imihajlow/discrete-clock/models/clock.asc

C1: cap; 1000µ
D1: diode; 1N4148
D2: diode; 1N4148
D3: diode; 1N4148
D4: diode; 1N4148
M1: nmos; 2N7002
M2: nmos; 2N7002
R1: res; 10
R2: res; 20k
R3: res; 20k
V1: voltage; 5
V2: voltage; SINE(0 6 50)
Named nets: 0, COM
.tran 0 1
