imihajlow/discrete-clock/models/reset.asc

C1: cap; 0.63µ
D1: diode; 1N4148
M1: nmos; 2N7002
M2: nmos; 2N7002
R1: res; 20k
R2: res; 100k
R3: res; 100k
R4: res; 20k
V1: voltage; PULSE(0 5 0 1m 1m 1 2)
Named nets: 0, COM
.tran 0 10
