imihajlow/discrete-clock/models/counter.asc

C1: cap; 1n
D1: diode; 1N4148
D2: diode; 1N4148
D3: diode; 1N4148
D4: diode; 1N4148
D5: diode; 1N4148
D6: diode; 1N4148
D7: diode; 1N4148
D8: diode; 1N4148
D9: diode; 1N4148
D10: diode; 1N4148
D11: diode; 1N4148
D12: diode; 1N4148
D13: diode; 1N4148
D14: diode; 1N4148
D15: LED; NSCW100
D16: LED; NSCW100
D17: LED; NSCW100
D18: LED; NSCW100
M1: nmos; 2N7002
M2: nmos; 2N7002
M3: nmos; 2N7002
R1: res; 20k
R2: res; 20k
R3: res; 10k
R4: res; 10k
R5: res; 10k
R6: res; 10k
R7: res; 40k
R8: res; 50
R9: res; 50
R10: res; 50
R11: res; 50
V1: voltage; 5
V2: voltage; PULSE(0 5 0 100n 100n 500m 1)
V3: voltage; PULSE(0 5 500m 100n 100n 500m 1)
V4: voltage; PULSE(0 5 2.6 1n 1n 29 60)
V5: voltage; PULSE(0 5 1700m 100n 100n 670m 1.7)
X1: ff-arst-nmos-diode
X2: ff-arst-nmos-diode
X3: ff-arst-nmos-diode
X4: ff-arst-nmos-diode
X5: ff-arst-nmos-diode
X6: ff-arst-nmos-diode
X7: ff-arst-nmos-diode
X8: ff-arst-nmos-diode
X9: nxor
Named nets: 0, RST, Q1, NQ1, Vcc, NQ2, NQ4, NQ8, Q2, Q4, Q8, RSTin, NC, C, Bin
.tran 0 40
