imihajlow/discrete-clock/models/nxor.asc

D1: diode; 1N4148
D2: diode; 1N4148
D3: diode; 1N4148
D4: diode; 1N4148
D5: diode; 1N4148
D6: diode; 1N4148
M1: nmos; 2N7002
M2: nmos; 2N7002
M3: nmos; 2N7002
M4: nmos; 2N7002
R1: res; 20k
R2: res; 20k
R3: res; 20k
R4: res; 20k
Named nets: A, NA, B, Q, NQ, 0, Vcc, NB
