imihajlow/discrete-clock/models/ff-arst-nmos-diode.asc

C1: cap; {C}
C2: cap; {C}
C3: cap; {C}
C4: cap; {C}
C5: cap; {C}
C6: cap; {C}
C7: cap; {C}
C8: cap; {C}
D1: diode; 1N4148
D2: diode; 1N4148
D3: diode; 1N4148
D4: diode; 1N4148
D5: diode; 1N4148
D6: diode; 1N4148
D7: diode; 1N4148
D8: diode; 1N4148
D9: diode; 1N4148
D10: diode; 1N4148
D11: diode; 1N4148
D12: diode; 1N4148
D13: diode; 1N4148
D14: diode; 1N4148
D15: diode; 1N4148
D16: diode; 1N4148
D17: diode; 1N4148
D18: diode; 1N4148
D19: diode; 1N4148
D20: diode; 1N4148
M1: nmos; 2N7002
M2: nmos; 2N7002
M3: nmos; 2N7002
M4: nmos; 2N7002
M5: nmos; 2N7002
M6: nmos; 2N7002
M7: nmos; 2N7002
M8: nmos; 2N7002
R1: res; {R}
R3: res; {R}
R5: res; {R}
R7: res; {R}
R9: res; {R}
R11: res; {R}
R13: res; {R}
R15: res; {R}
Named nets: 0, NCLK, ARST, CLK, Q, NQ, Vcc, G1, G2, G3, G4, G5, G6, G7, G8, NS1, NR1, NS2, NR2, Q0, NQ0
.param R=20k
.param C=0.01p
