imihajlow/discrete-clock/models/ff-async-reset-nmos-res.asc

M1: nmos; 2N7002
M2: nmos; 2N7002
M3: nmos; 2N7002
M4: nmos; 2N7002
M5: nmos; 2N7002
M6: nmos; 2N7002
M7: nmos; 2N7002
M8: nmos; 2N7002
M9: nmos; 2N7002
M10: nmos; 2N7002
M11: nmos; 2N7002
M12: nmos; 2N7002
M13: nmos; 2N7002
M14: nmos; 2N7002
M15: nmos; 2N7002
M16: nmos; 2N7002
M17: nmos; 2N7002
M18: nmos; 2N7002
M19: nmos; 2N7002
M20: nmos; 2N7002
M21: nmos; 2N7002
R1: res; 5k
R2: res; 5k
R3: res; 5k
R4: res; 5k
R5: res; 5k
R6: res; 5k
R7: res; 5k
R8: res; 5k
R9: res; 1k
V1: voltage; 5
V2: voltage; PULSE(0 5 0 10u 10u 1 2)
V3: voltage; PULSE(0 5 400m 1m 1m 5.6666 6.73285)
Named nets: Vcc, 0, CLK, !CLK, RI, Q, QI, RES, SI
.tran 10u 60
