imihajlow/discrete-clock/sch/display-module/display-module.kicad_pcb

## KiCad design sch/display-module/display-module.kicad_pcb (2019-01-13)

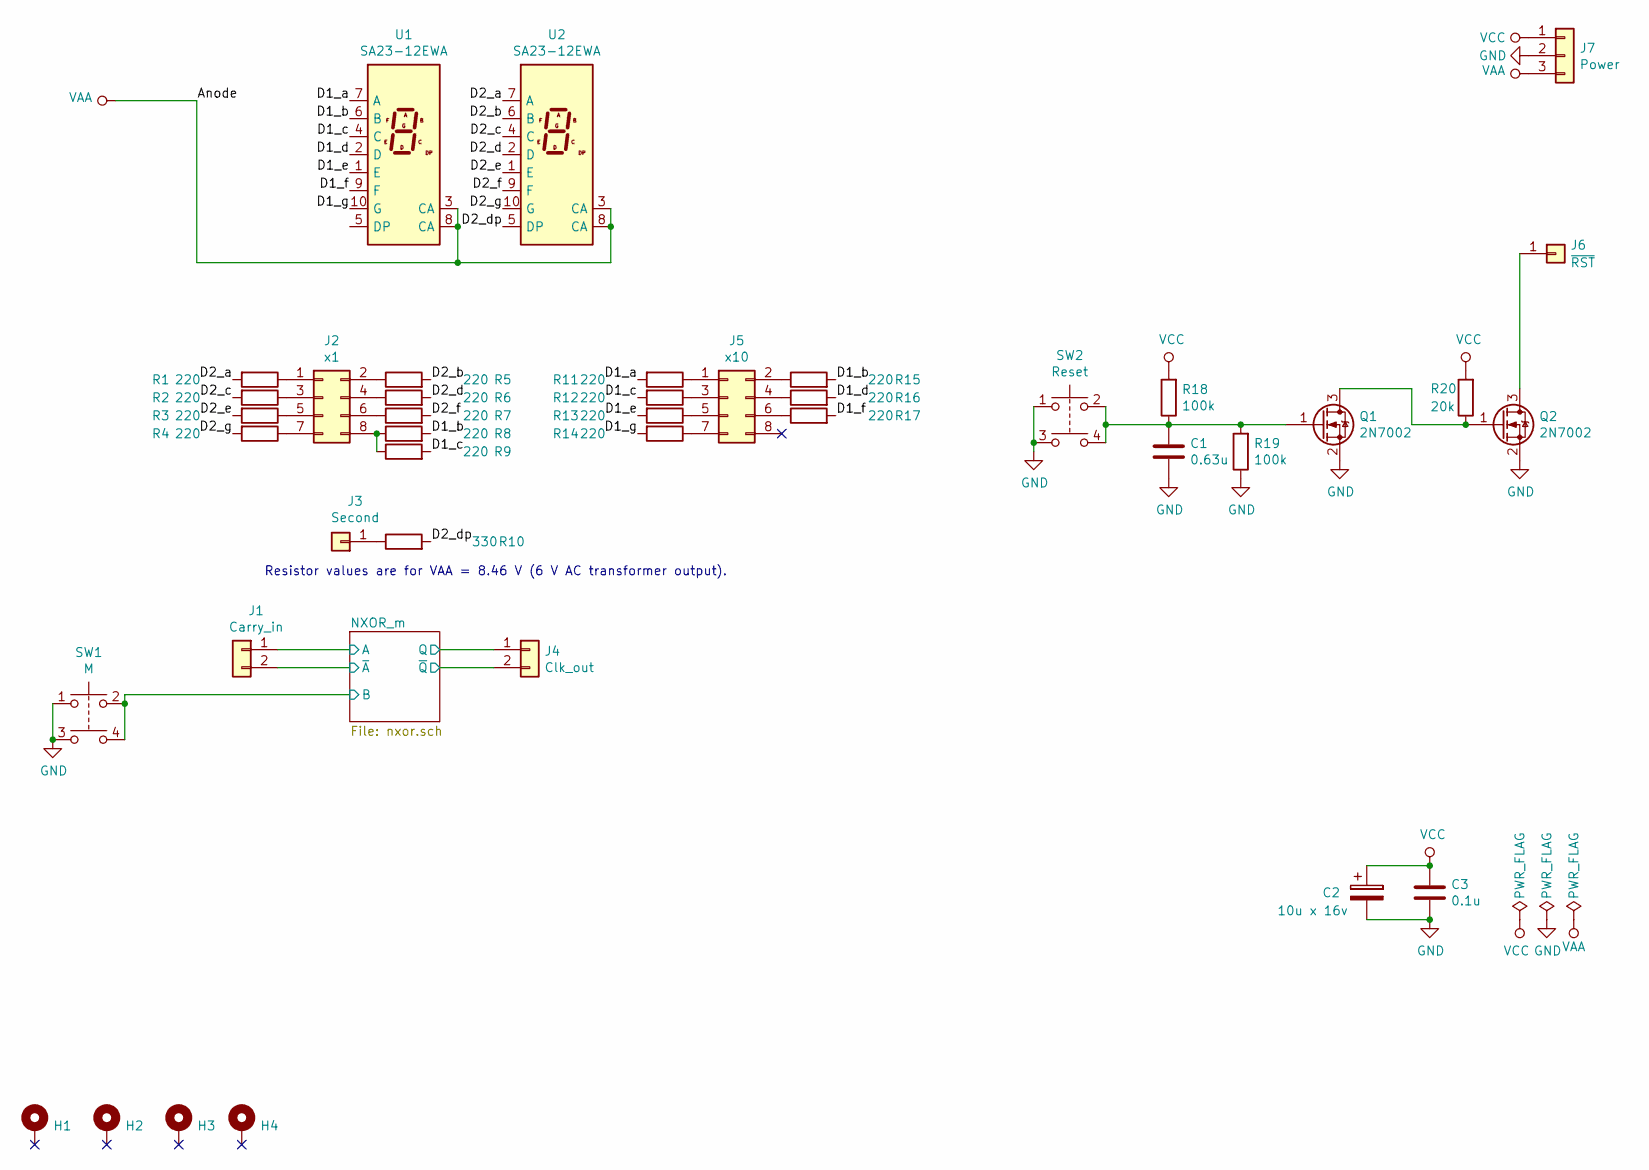
[picture p1: schematic display-module.sch]

Parts:
C1: 0.63u; C_0805_2012Metric
C2: 10u x 16v; CP_EIA-3528-21_Kemet-B_Pad1.50x2.35mm_HandSolder
C3: 0.1u; C_0805_2012Metric
H1, H2, H3, H4: MountingHole_Pad; MountingHole_3.2mm_M3_DIN965_Pad
J1: Carry_in; PinHeader_1x02_P2.54mm_Vertical
J2: x1; IDC-Header_2x04_P2.54mm_Vertical
J3: Second; PinHeader_1x01_P2.54mm_Vertical
J4: Clk_out; PinHeader_1x02_P2.54mm_Vertical
J5: x10; IDC-Header_2x04_P2.54mm_Vertical
J6: ~RST; PinHeader_1x01_P2.54mm_Vertical
J7: Power; PinHeader_1x03_P2.54mm_Vertical
Q1, Q2: 2N7002; SOT-23
R1, R2, R3, R4, R5, R6, R7, R8, R9, R11, R12, R13, R14, R15, R16, R17: 220; R_0805_2012Metric
R10: 330; R_0805_2012Metric
R18, R19: 100k; R_0805_2012Metric
R20: 20k; R_0805_2012Metric
SW1: M; DTS-644
SW2: Reset; DTS-644
U1, U2: SA23-12EWA; SA10-21HWA

Connections:
/D1_a: R11.2, U1.7 (A)
/D1_b: R8.2, R15.2, U1.6 (B)
/D1_c: R9.2, R12.2, U1.4 (C)
/D1_d: R16.2, U1.2 (D)
/D1_e: R13.2, U1.1 (E)
/D1_f: R17.2, U1.9 (F)
/D1_g: R14.2, U1.10 (G)
/D2_a: R1.2, U2.7 (A)
/D2_b: R5.2, U2.6 (B)
/D2_c: R2.2, U2.4 (C)
/D2_d: R6.2, U2.2 (D)
/D2_dp: R10.2, U2.5 (DP)
/D2_e: R3.2, U2.1 (E)
/D2_f: R7.2, U2.9 (F)
/D2_g: R4.2, U2.10 (G)
/NXOR_m/A: J1.1; also elsewhere on the board
/NXOR_m/B: SW1.2, SW1.4; also elsewhere on the board
/NXOR_m/Q: J4.1; also elsewhere on the board
/NXOR_m/~A: J1.2; also elsewhere on the board
/NXOR_m/~Q: J4.2; also elsewhere on the board
GND: C1.2, C2.2, C3.2, J7.2, Q1.2 (S), Q2.2 (S), R19.1, SW1.1, SW1.3, SW2.1, SW2.3; also elsewhere on the board
unnamed: C1.1, Q1.1 (G), R18.1, R19.2, SW2.2, SW2.4
unnamed: J2.1, R1.1
unnamed: J2.2, R5.1
unnamed: J2.3, R2.1
unnamed: J2.4, R6.1
unnamed: J2.5, R3.1
unnamed: J2.6, R7.1
unnamed: J2.7, R4.1
unnamed: J2.8, R8.1, R9.1
unnamed: J3.1, R10.1
unnamed: J5.1, R11.1
unnamed: J5.2, R15.1
unnamed: J5.3, R12.1
unnamed: J5.4, R16.1
unnamed: J5.5, R13.1
unnamed: J5.6, R17.1
unnamed: J5.7, R14.1
unnamed: J6.1, Q2.3 (D)
unnamed: Q1.3 (D), Q2.1 (G), R20.1
VAA: J7.3, U1.3 (CA), U1.8 (CA), U2.3 (CA), U2.8 (CA)
VCC: C2.1, C3.1, J7.1, R18.2, R20.2; also elsewhere on the board

Notes on the sheet:
Resistor values are for VAA = 8.46 V (6 V AC transformer output).

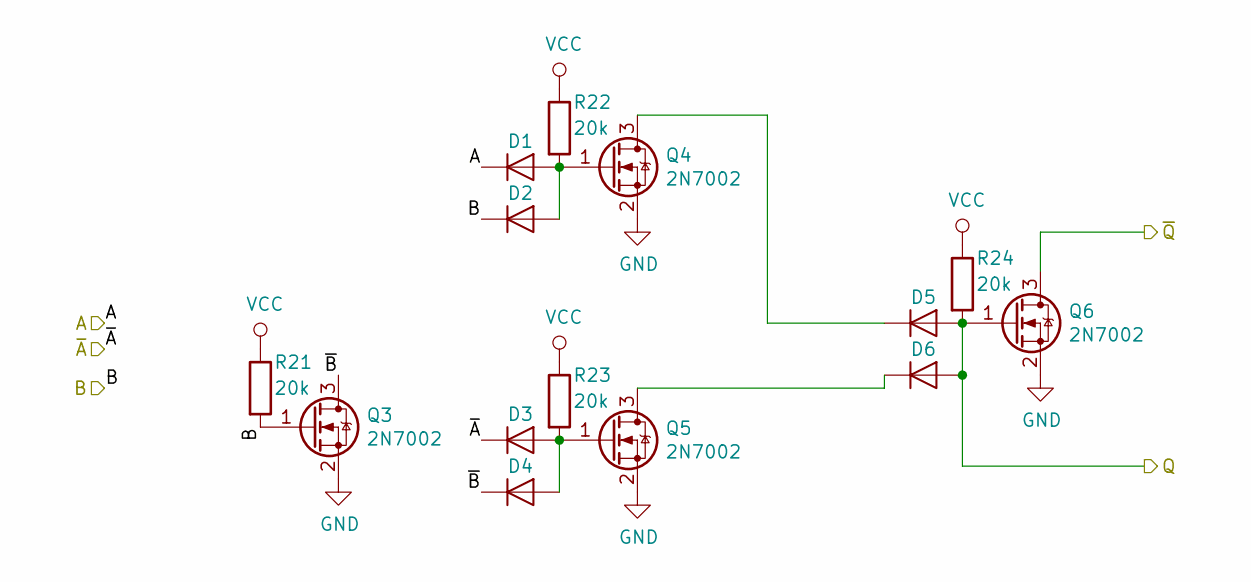
[picture p2: schematic nxor.sch]

Parts:
D1, D2, D3, D4, D5, D6: LL103C; D_MiniMELF
Q3, Q4, Q5, Q6: 2N7002; SOT-23
R21, R22, R23, R24: 20k; R_0805_2012Metric

Connections:
/NXOR_m/A: D1.1 (K); also elsewhere on the board
/NXOR_m/B: D2.1 (K), Q3.1 (G), R21.2; also elsewhere on the board
/NXOR_m/Q: D5.2 (A), D6.2 (A), Q6.1 (G), R24.2; also elsewhere on the board
/NXOR_m/~A: D3.1 (K); also elsewhere on the board
/NXOR_m/~B: D4.1 (K), Q3.3 (D)
/NXOR_m/~Q: Q6.3 (D); also elsewhere on the board
GND: Q3.2 (S), Q4.2 (S), Q5.2 (S), Q6.2 (S); also elsewhere on the board
unnamed: D1.2 (A), D2.2 (A), Q4.1 (G), R22.2
unnamed: D3.2 (A), D4.2 (A), Q5.1 (G), R23.2
unnamed: D5.1 (K), Q4.3 (D)
unnamed: D6.1 (K), Q5.3 (D)
VCC: R21.1, R22.1, R23.1, R24.1; also elsewhere on the board

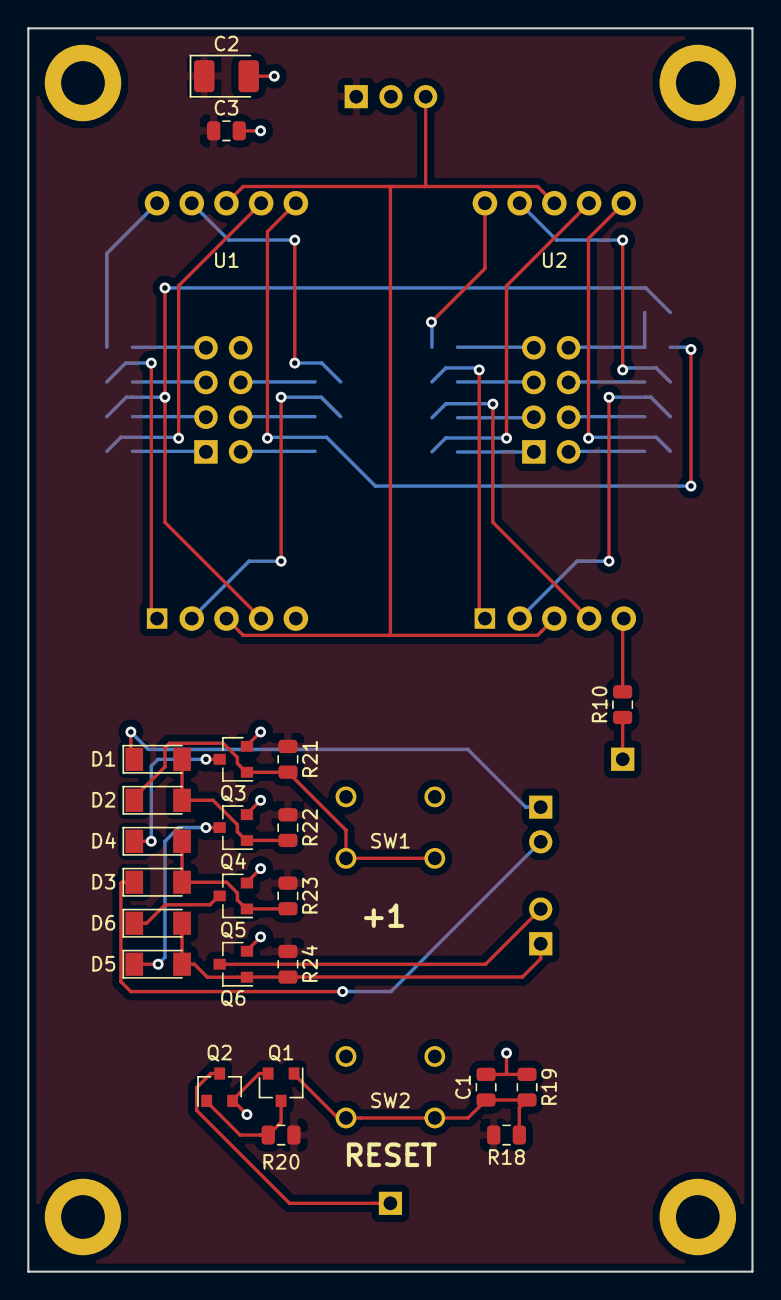
[picture p3: board display-module.kicad_pcb from above]

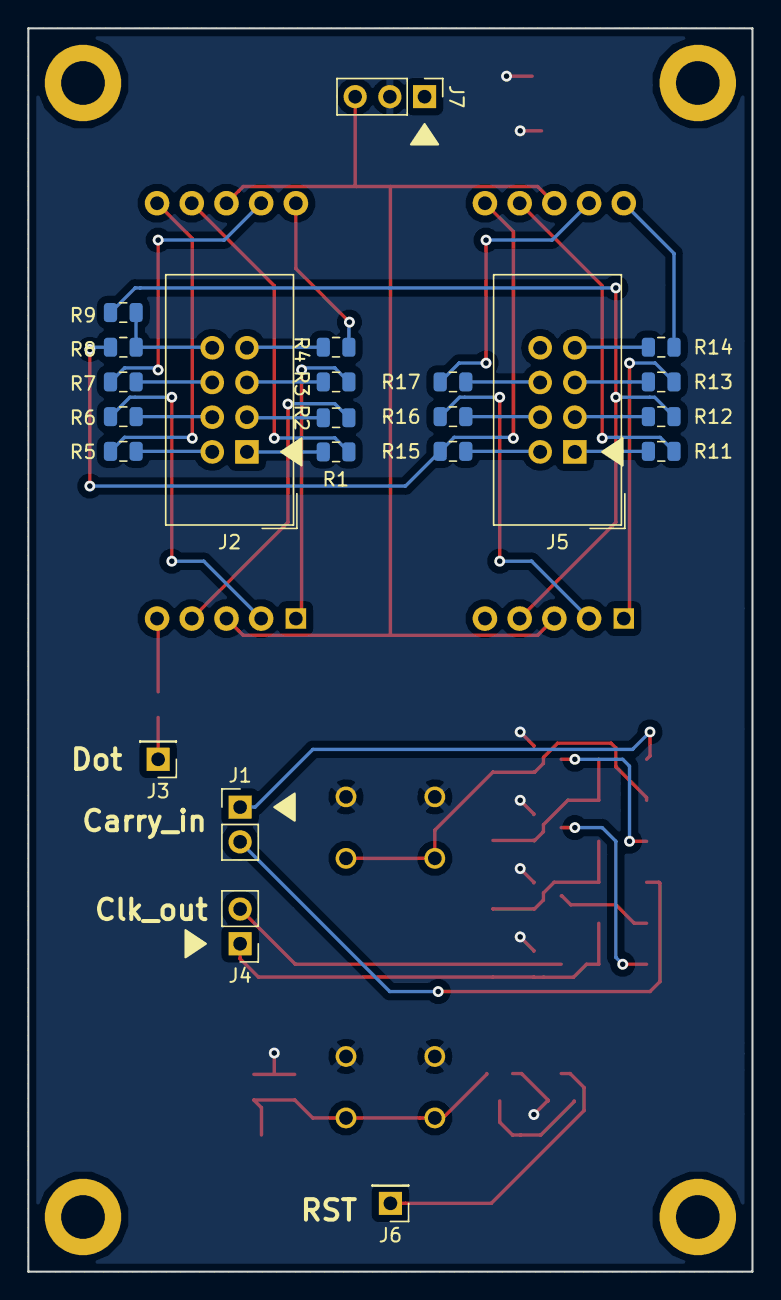
[picture p4: board display-module.kicad_pcb from below]

Board: 2 copper layers, 53.0 x 91.0 mm, 54 parts (23 on the bottom side), 47 nets.
