imihajlow/discrete-clock/sch/power/power.kicad_pcb

## KiCad design sch/power/power.kicad_pcb (2019-01-13)

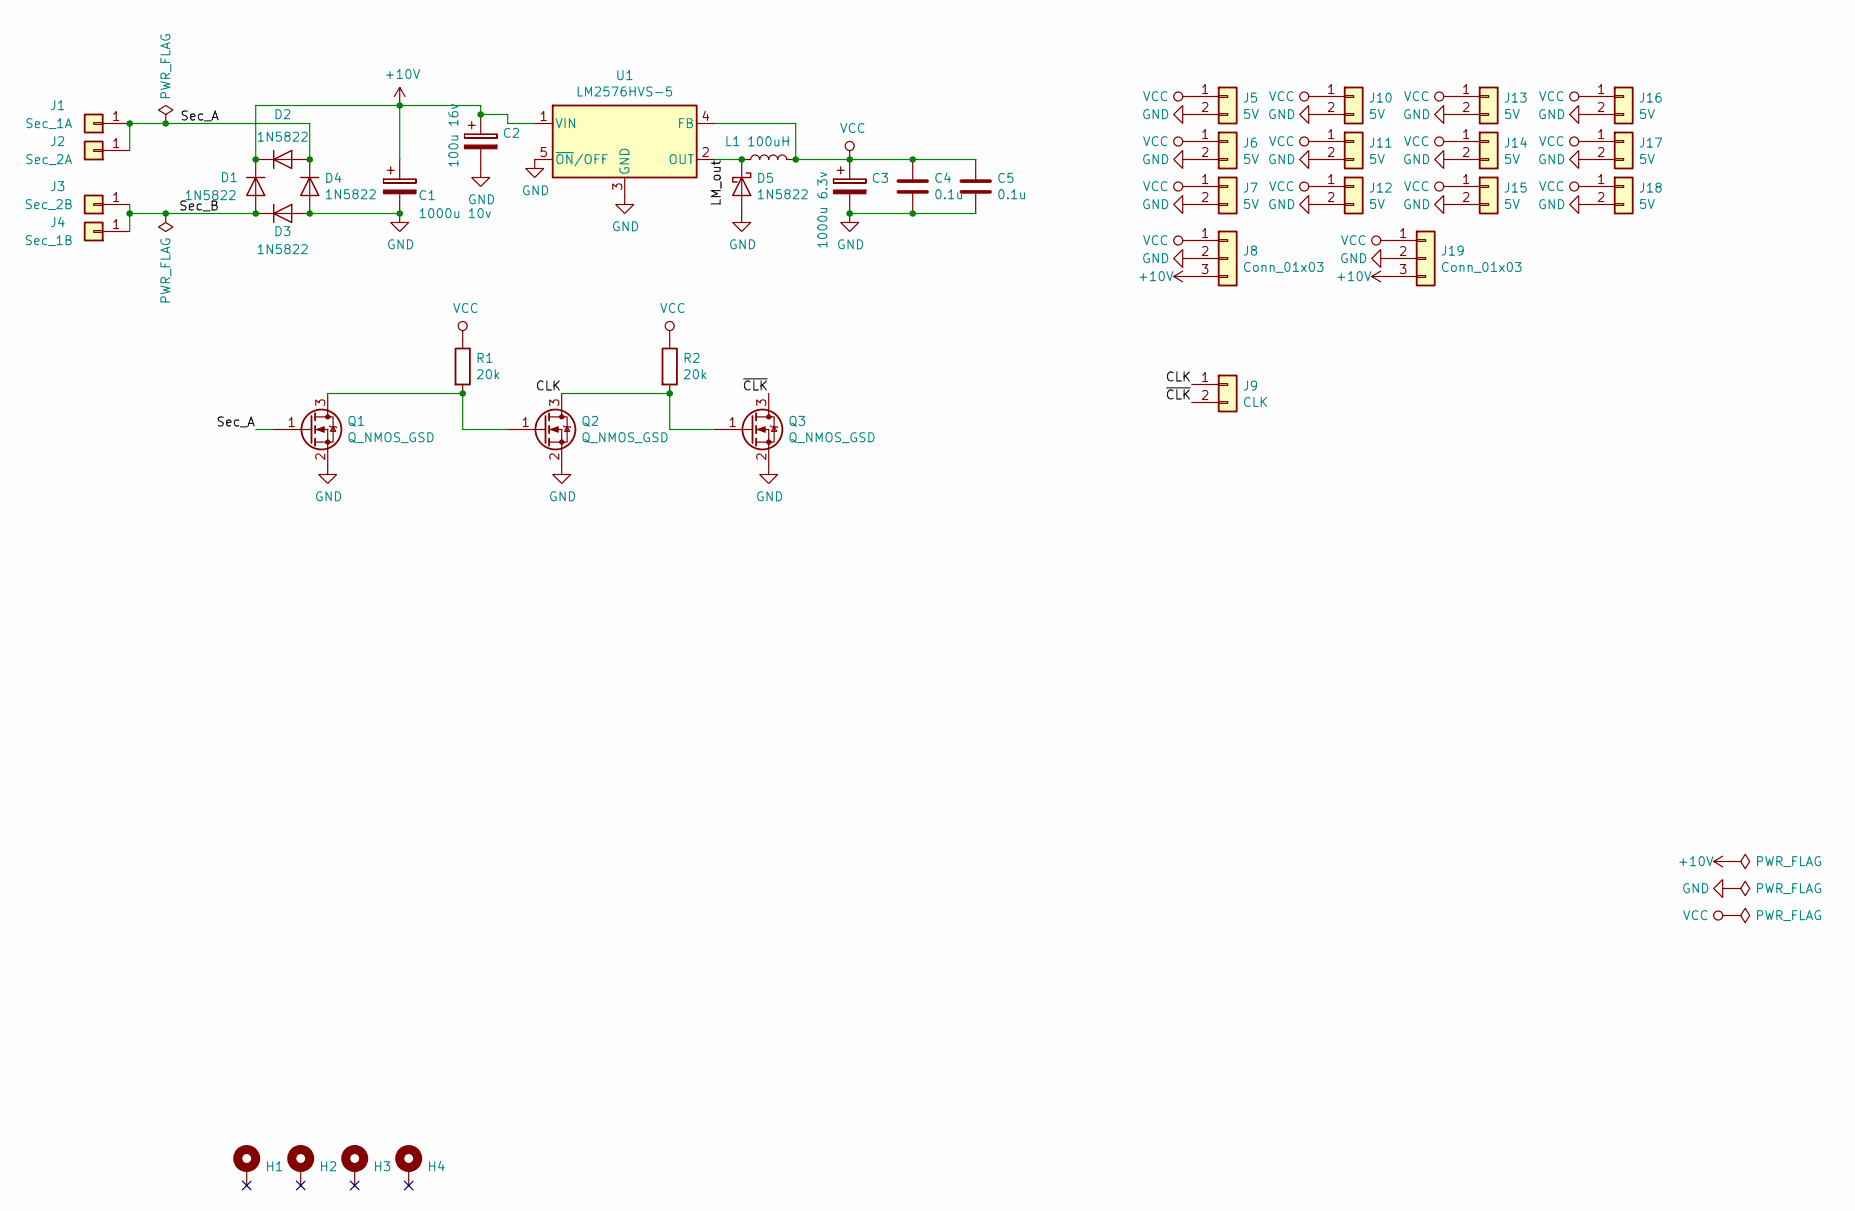
[picture p5: schematic power.sch]

Parts:
C1: 1000u 10v; CP_Elec_10x10
C2: 100u 16v; CP_Elec_6.3x5.4
C3: 1000u 6.3v; CP_Elec_8x10.5
C4, C5: 0.1u; C_0805_2012Metric
D1, D2, D3, D4, D5: 1N5822; D_DO-201AD_P12.70mm_Horizontal
H1, H2, H3, H4: MountingHole_Pad; MountingHole_3.2mm_M3_DIN965_Pad
J1: Sec_1A; SolderWirePad_1x01_Drill1.5mm
J2: Sec_2A; SolderWirePad_1x01_Drill1.5mm
J3: Sec_2B; SolderWirePad_1x01_Drill1.5mm
J4: Sec_1B; SolderWirePad_1x01_Drill1.5mm
J5, J6, J7, J10, J11, J12, J13, J14, J15, J16, J17, J18: 5V; PinHeader_1x02_P2.54mm_Vertical
J8, J19: Conn_01x03; PinHeader_1x03_P2.54mm_Vertical
J9: CLK; PinHeader_1x02_P2.54mm_Vertical
L1: 100uH; L_Wuerth_WE-PD-Typ-LS_Handsoldering
Q1, Q2, Q3: Q_NMOS_GSD; SOT-23
R1, R2: 20k; R_0805_2012Metric
U1: LM2576HVS-5; TO-263-5_TabPin3

Connections:
+10V: C1.1, C2.1, D1.1 (K), D2.1 (K), J8.3, J19.3, U1.1 (VIN)
/CLK: J9.1, Q2.3 (D), Q3.1 (G), R2.2
/LM_out: D5.1 (K), L1.1, U1.2 (OUT)
/Sec_A: D2.2 (A), D4.1 (K), J1.1, J2.1, Q1.1 (G)
/Sec_B: D1.2 (A), D3.1 (K), J3.1, J4.1
/~CLK: J9.2, Q3.3 (D)
GND: C1.2, C2.2, C3.2, C4.2, C5.2, D3.2 (A), D4.2 (A), D5.2 (A), J5.2, J6.2, J7.2, J8.2, J10.2, J11.2, J12.2, J13.2, J14.2, J15.2, J16.2, J17.2, J18.2, J19.2, Q1.2 (S), Q2.2 (S), Q3.2 (S), U1.3 (GND), U1.5 (~ON~/OFF)
unnamed: Q1.3 (D), Q2.1 (G), R1.2
VCC: C3.1, C4.1, C5.1, J5.1, J6.1, J7.1, J8.1, J10.1, J11.1, J12.1, J13.1, J14.1, J15.1, J16.1, J17.1, J18.1, J19.1, L1.2, R1.1, R2.1, U1.4 (FB)

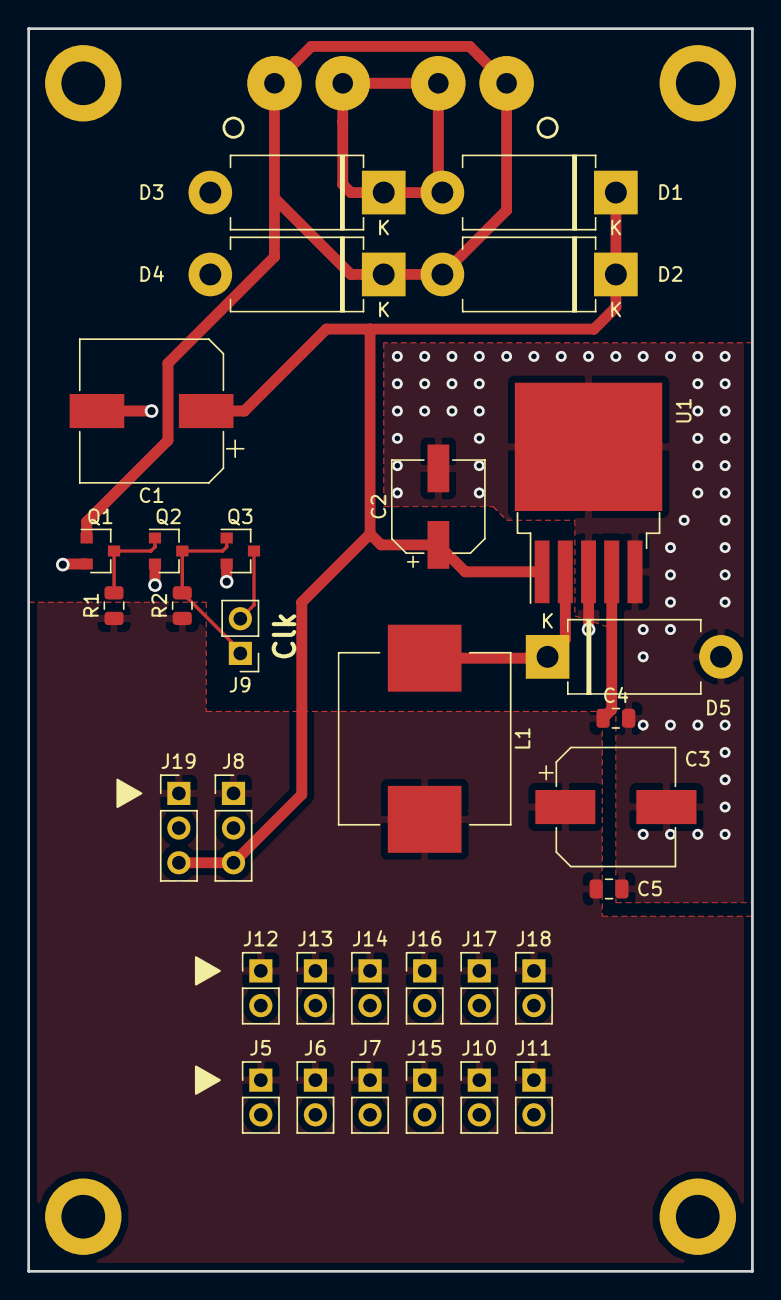
[picture p6: board power.kicad_pcb from above]

Board: 2 copper layers, 53.0 x 91.0 mm, 40 parts (0 on the bottom side), 9 nets.
