imihajlow/discrete-clock/sch/display/display.kicad_pcb

## KiCad design sch/display/display.kicad_pcb (2019-01-12)

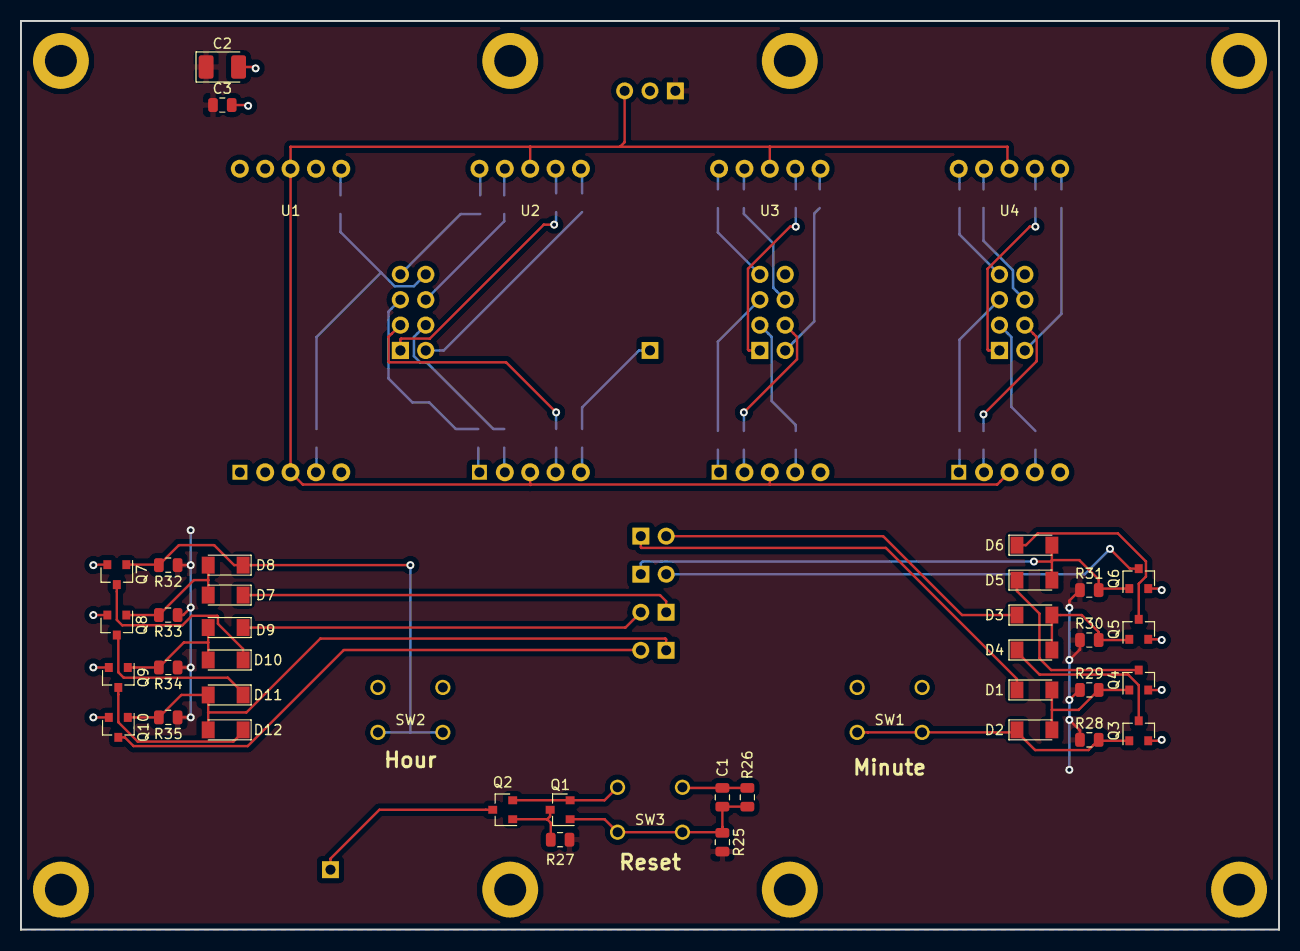
[picture p7: board display.kicad_pcb from above]

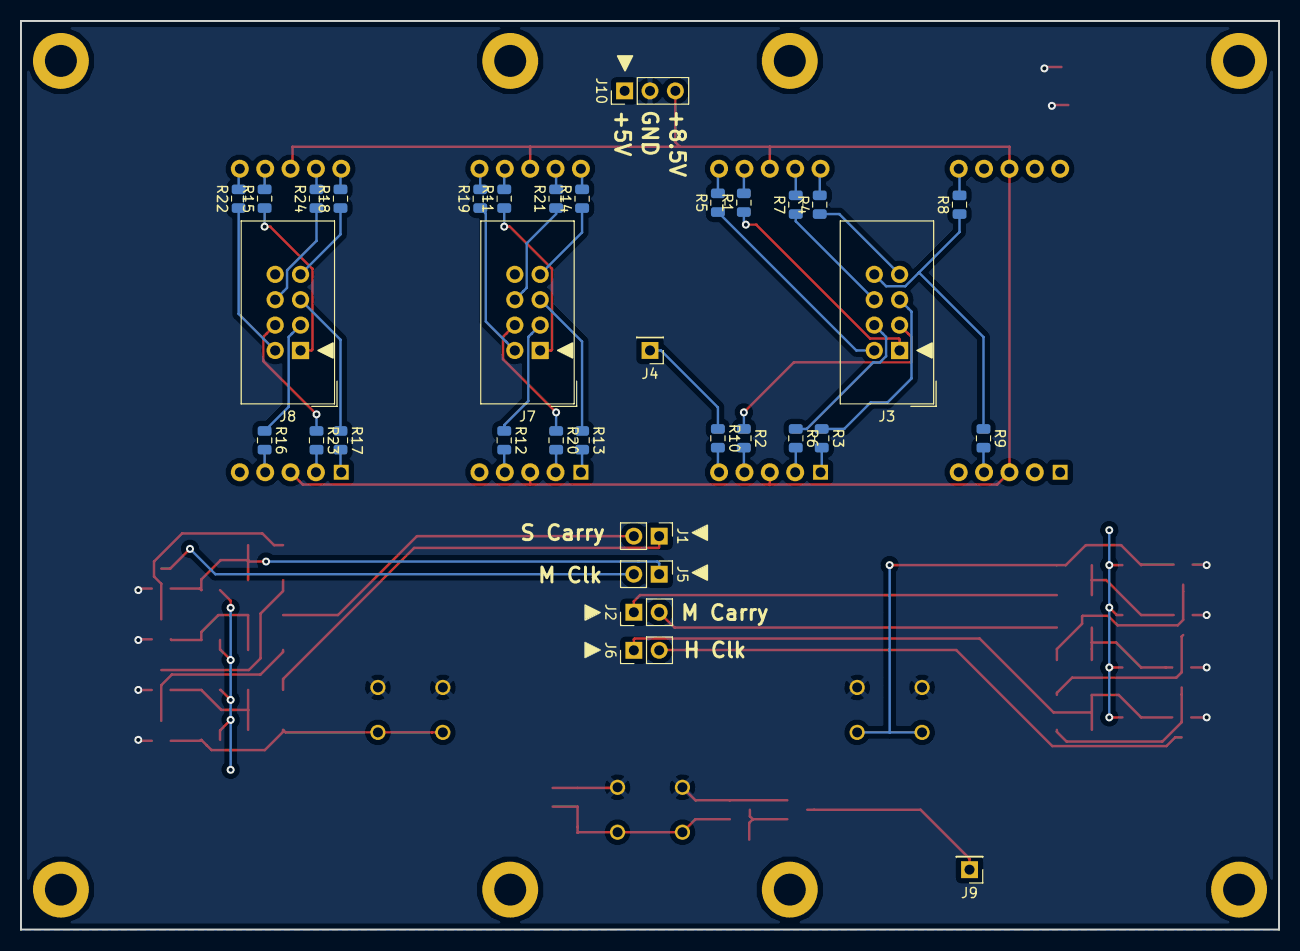
[picture p8: board display.kicad_pcb from below]

Board: 2 copper layers, 126.0 x 91.0 mm, 85 parts (34 on the bottom side), 73 nets.

Parts:
C1: 0.63u; C_0805_2012Metric
C2: 10u x 16v; CP_EIA-3528-21_Kemet-B_Pad1.50x2.35mm_HandSolder
C3: 0.1u; C_0805_2012Metric
D1, D2, D3, D4, D5, D6, D7, D8, D9, D10, D11, D12: LL103C; D_MiniMELF
H1, H2, H3, H4, H5, H6, H7, H8: MountingHole_Pad; MountingHole_3.2mm_M3_DIN965_Pad
J1: S_Carry; PinHeader_1x02_P2.54mm_Vertical
J2: M_Carry; PinHeader_1x02_P2.54mm_Vertical
J3: Hour; IDC-Header_2x04_P2.54mm_Vertical
J4: Second; PinHeader_1x01_P2.54mm_Vertical
J5: M_CLK; PinHeader_1x02_P2.54mm_Vertical
J6: H_CLK; PinHeader_1x02_P2.54mm_Vertical
J7: Minute10; IDC-Header_2x04_P2.54mm_Vertical
J8: Minute1; IDC-Header_2x04_P2.54mm_Vertical
J9: ~RST; PinHeader_1x01_P2.54mm_Vertical
J10: Power; PinHeader_1x03_P2.54mm_Vertical
Q1, Q2, Q3, Q4, Q5, Q6, Q7, Q8, Q9, Q10: 2N7002; SOT-23
R1, R2, R3, R4, R5, R6, R7, R8, R9, R11, R12, R13, R14, R15, R16, R17, R18, R19, R20, R21, R22, R23, R24: 15; R_0805_2012Metric
R10: 270; R_0805_2012Metric
R25, R26: 100k; R_0805_2012Metric
R27, R28, R29, R30, R31, R32, R33, R34, R35: 20k; R_0805_2012Metric
SW1: M; DTS-644
SW2: H; DTS-644
SW3: Reset; DTS-644
U1, U2, U3, U4: SA23-12EWA; SA10-21HWA

Connections:
/D1_b: R8.2, U1.6
/D1_c: R9.2, U1.4
/D2_a: R1.2, U2.7
/D2_b: R5.2, U2.6
/D2_c: R2.2, U2.4
/D2_d: R6.2, U2.2
/D2_dp: R10.2, U2.5
/D2_e: R3.2, U2.1
/D2_f: R7.2, U2.9
/D2_g: R4.2, U2.10
/D3_a: R11.2, U3.7
/D3_b: R19.2, U3.6
/D3_c: R12.2, U3.4
/D3_d: R20.2, U3.2
/D3_e: R13.2, U3.1
/D3_f: R21.2, U3.9
/D3_g: R14.2, U3.10
/D4_a: R15.2, U4.7
/D4_b: R22.2, U4.6
/D4_c: R16.2, U4.4
/D4_d: R23.2, U4.2
/D4_e: R17.2, U4.1
/D4_f: R24.2, U4.9
/D4_g: R18.2, U4.10
/NXOR_h/A: D7.1, J2.1
/NXOR_h/B: D8.1, Q7.1, R32.2, SW2.2, SW2.4
/NXOR_h/Q: D11.2, D12.2, J6.1, Q10.1, R35.2
/NXOR_h/~A: D9.1, J2.2
/NXOR_h/~B: D10.1, Q7.3
/NXOR_h/~Q: J6.2, Q10.3
/NXOR_m/A: D1.1, J1.1
/NXOR_m/B: D2.1, Q3.1, R28.2, SW1.2, SW1.4
/NXOR_m/Q: D5.2, D6.2, J5.1, Q6.1, R31.2
/NXOR_m/~A: D3.1, J1.2
/NXOR_m/~B: D4.1, Q3.3
/NXOR_m/~Q: J5.2, Q6.3
GND: C1.2, C2.2, C3.2, J10.2, Q1.2, Q2.2, Q3.2, Q4.2, Q5.2, Q6.2, Q7.2, Q8.2, Q9.2, Q10.2, R26.1, SW1.1, SW1.3, SW2.1, SW2.3, SW3.1, SW3.3
unnamed: C1.1, Q1.1, R25.1, R26.2, SW3.2, SW3.4
unnamed: D1.2, D2.2, Q4.1, R29.2
unnamed: D3.2, D4.2, Q5.1, R30.2
unnamed: D5.1, Q4.3
unnamed: D6.1, Q5.3
unnamed: D7.2, D8.2, Q8.1, R33.2
unnamed: D9.2, D10.2, Q9.1, R34.2
unnamed: D11.1, Q8.3
unnamed: D12.1, Q9.3
unnamed: J3.1, R1.1
unnamed: J3.2, R5.1
unnamed: J3.3, R2.1
unnamed: J3.4, R6.1
unnamed: J3.5, R3.1
unnamed: J3.6, R7.1
unnamed: J3.7, R4.1
unnamed: J3.8, R8.1, R9.1
unnamed: J4.1, R10.1
unnamed: J7.1, R11.1
unnamed: J7.2, R19.1
unnamed: J7.3, R12.1
unnamed: J7.4, R20.1
unnamed: J7.5, R13.1
unnamed: J7.6, R21.1
unnamed: J7.7, R14.1
unnamed: J8.1, R15.1
unnamed: J8.2, R22.1
unnamed: J8.3, R16.1
unnamed: J8.4, R23.1
unnamed: J8.5, R17.1
unnamed: J8.6, R24.1
unnamed: J8.7, R18.1
unnamed: J9.1, Q2.3
unnamed: Q1.3, Q2.1, R27.1
VAA: J10.3, U1.3, U1.8, U2.3, U2.8, U3.3, U3.8, U4.3, U4.8
VCC: C2.1, C3.1, J10.1, R25.2, R27.2, R28.1, R29.1, R30.1, R31.1, R32.1, R33.1, R34.1, R35.1
