imihajlow/discrete-clock/sch/counter/counter.kicad_pcb

## KiCad design sch/counter/counter.kicad_pcb (2019-01-09)

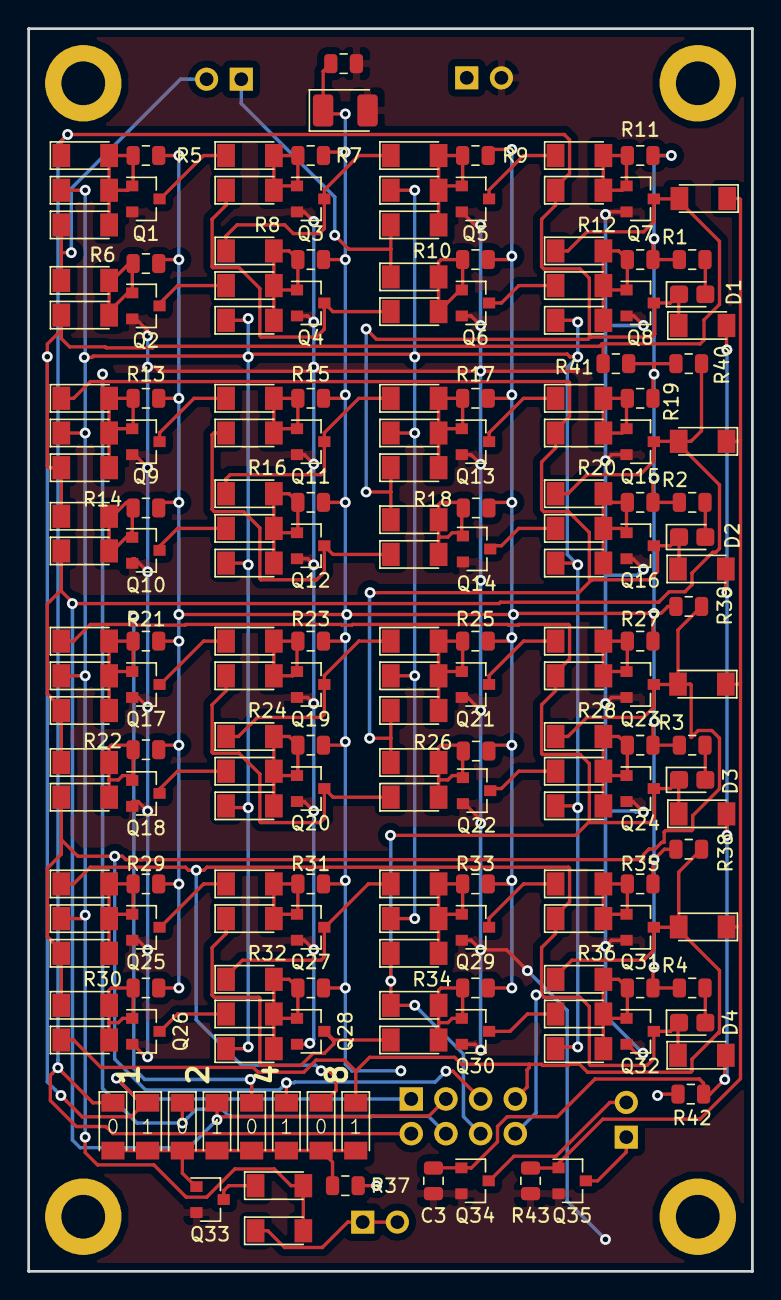
[picture p9: board counter.kicad_pcb from above]

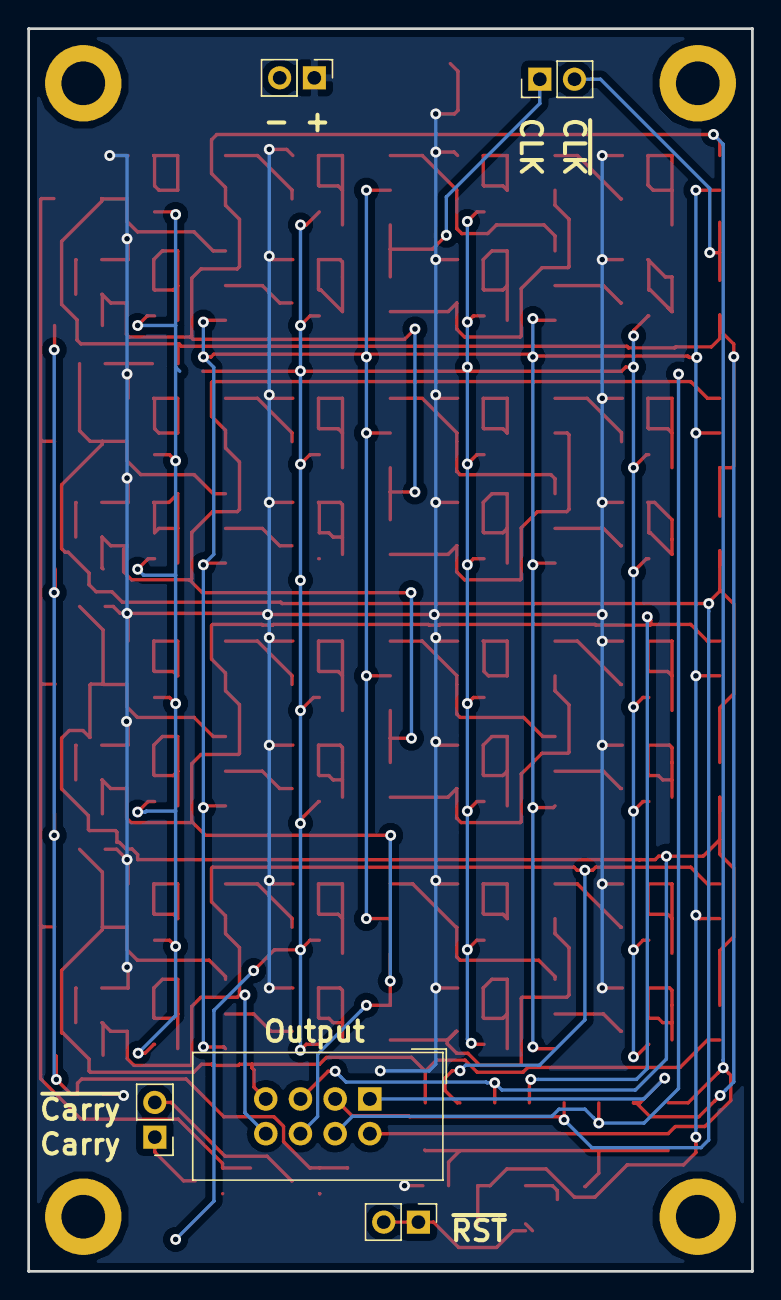
[picture p10: board counter.kicad_pcb from below]

Board: 2 copper layers, 53.0 x 91.0 mm, 192 parts (5 on the bottom side), 80 nets.

Parts:
C1: .1u; C_0805_2012Metric
C2: 10u 16v; CP_EIA-3528-21_Kemet-B_Pad1.50x2.35mm_HandSolder
C3: 1n; C_0805_2012Metric
D1, D2, D3, D4: LED; LED_0805_2012Metric_Castellated
D5, D6, D7, D8, D9, D10, D11, D12, D13, D14, D15, D16, D17, D18, D19, D20, D21, D22, D23, D24, D25, D26, D27, D28, D29, D30, D31, D32, D33, D34, D35, D36, D37, D38, D39, D40, D41, D42, D43, D44, D45, D46, D47, D48, D49, D50, D51, D52, D53, D54, D55, D56, D57, D58, D59, D60, D61, D62, D63, D64, D65, D66, D67, D68, D69, D70, D71, D72, D73, D74, D75, D76, D77, D78, D79, D80, D81, D82, D83, D84, D85, D86, D87, D88, D89, D90, D91, D92, D97, D98, D99, D100, D101, D102, D103, D104, D105, D106: D; D_MiniMELF
H1, H2, H3, H4: MountingHole_Pad; MountingHole_3.2mm_M3_DIN965_Pad
J1: CLK; PinHeader_1x02_P2.54mm_Vertical
J2: Carry; PinHeader_1x02_P2.54mm_Vertical
J3: Power; PinHeader_1x02_P2.54mm_Vertical
J4: Q; IDC-Header_2x04_P2.54mm_Vertical
J5: ~RST; PinHeader_1x02_P2.54mm_Vertical
Q1, Q2, Q3, Q4, Q5, Q6, Q7, Q8, Q9, Q10, Q11, Q12, Q13, Q14, Q15, Q16, Q17, Q18, Q19, Q20, Q21, Q22, Q23, Q24, Q25, Q26, Q27, Q28, Q29, Q30, Q31, Q32, Q33, Q34, Q35: Q_NMOS_GSD; SOT-23
R1, R2, R3, R4: 330; R_0805_2012Metric
R5, R6, R7, R8, R9, R10, R11, R12, R13, R14, R15, R16, R17, R18, R19, R20, R21, R22, R23, R24, R25, R26, R27, R28, R29, R30, R31, R32, R33, R34, R35, R36, R37, R42: 20k; R_0805_2012Metric
R38, R39, R40, R41: 10k; R_0805_2012Metric
R43: 40k; R_0805_2012Metric

Connections:
/CLK: D16.1, D19.1, J1.1
/Cout: J2.1, Q35.3
/Q1: D8.1, D22.1, D26.1, D29.1, D85.1, D103.2, J4.1, Q7.3, R41.2
/Q2: D28.1, D42.1, D46.1, D49.1, D87.1, D104.2, J4.3, Q15.3, R40.2
/Q4: D48.1, D62.1, D66.1, D69.1, D89.1, D105.2, J4.5, Q23.3, R39.2
/Q8: D68.1, D82.1, D91.1, D106.2, J4.7, Q31.3, R38.2
/~ARST: D7.1, D14.1, D17.1, D24.1, D27.1, D34.1, D37.1, D44.1, D47.1, D54.1, D57.1, D64.1, D67.1, D74.1, D77.1, D84.1, D97.2, D98.2
/~CLK: D6.1, D9.1, J1.2
/~Cout: J2.2, Q34.3
/~Q1: D1.1, D5.1, D21.1, D36.1, D39.1, D86.1, D99.1, J4.2, Q8.3
/~Q2: D2.1, D25.1, D41.1, D56.1, D59.1, D88.1, D100.1, J4.4, Q16.3
/~Q4: D3.1, D45.1, D61.1, D76.1, D79.1, D90.1, D101.1, J4.6, Q24.3
/~Q8: D4.1, D65.1, D81.1, D92.1, D102.1, J4.8, Q32.3
/~RSTin: D98.1, J5.1, J5.2
GND: C1.2, C2.2, C3.2, J3.2, Q1.2, Q2.2, Q3.2, Q4.2, Q5.2, Q6.2, Q7.2, Q8.2, Q9.2, Q10.2, Q11.2, Q12.2, Q13.2, Q14.2, Q15.2, Q16.2, Q17.2, Q18.2, Q19.2, Q20.2, Q21.2, Q22.2, Q23.2, Q24.2, Q25.2, Q26.2, Q27.2, Q28.2, Q29.2, Q30.2, Q31.2, Q32.2, Q33.2, Q34.2, Q35.2, R43.2
unnamed: C3.1, D99.2, D100.2, D101.2, D102.2, Q34.1, R42.2
unnamed: D1.2, R1.2
unnamed: D2.2, R2.2
unnamed: D3.2, R3.2
unnamed: D4.2, R4.2
unnamed: D5.2, D6.2, D7.2, Q1.1, R5.2
unnamed: D8.2, D9.2, Q2.1, R6.2
unnamed: D10.1, Q1.3
unnamed: D10.2, D11.2, Q3.1, R7.2
unnamed: D11.1, D18.1, Q4.3
unnamed: D12.1, D15.1, Q3.3
unnamed: D12.2, D13.2, D14.2, Q4.1, R8.2
unnamed: D13.1, Q2.3
unnamed: D15.2, D16.2, D17.2, Q5.1, R9.2
unnamed: D18.2, D19.2, Q6.1, R10.2
unnamed: D20.1, Q5.3
unnamed: D20.2, D21.2, Q7.1, R11.2
unnamed: D22.2, D23.2, D24.2, Q8.1, R12.2
unnamed: D23.1, Q6.3
unnamed: D25.2, D26.2, D27.2, Q9.1, R13.2
unnamed: D28.2, D29.2, Q10.1, R14.2
unnamed: D30.1, Q9.3
unnamed: D30.2, D31.2, Q11.1, R15.2
unnamed: D31.1, D38.1, Q12.3
unnamed: D32.1, D35.1, Q11.3
unnamed: D32.2, D33.2, D34.2, Q12.1, R16.2
unnamed: D33.1, Q10.3
unnamed: D35.2, D36.2, D37.2, Q13.1, R17.2
unnamed: D38.2, D39.2, Q14.1, R18.2
unnamed: D40.1, Q13.3
unnamed: D40.2, D41.2, Q15.1, R19.2
unnamed: D42.2, D43.2, D44.2, Q16.1, R20.2
unnamed: D43.1, Q14.3
unnamed: D45.2, D46.2, D47.2, Q17.1, R21.2
unnamed: D48.2, D49.2, Q18.1, R22.2
unnamed: D50.1, Q17.3
unnamed: D50.2, D51.2, Q19.1, R23.2
unnamed: D51.1, D58.1, Q20.3
unnamed: D52.1, D55.1, Q19.3
unnamed: D52.2, D53.2, D54.2, Q20.1, R24.2
unnamed: D53.1, Q18.3
unnamed: D55.2, D56.2, D57.2, Q21.1, R25.2
unnamed: D58.2, D59.2, Q22.1, R26.2
unnamed: D60.1, Q21.3
unnamed: D60.2, D61.2, Q23.1, R27.2
unnamed: D62.2, D63.2, D64.2, Q24.1, R28.2
unnamed: D63.1, Q22.3
unnamed: D65.2, D66.2, D67.2, Q25.1, R29.2
unnamed: D68.2, D69.2, Q26.1, R30.2
unnamed: D70.1, Q25.3
unnamed: D70.2, D71.2, Q27.1, R31.2
unnamed: D71.1, D78.1, Q28.3
unnamed: D72.1, D75.1, Q27.3
unnamed: D72.2, D73.2, D74.2, Q28.1, R32.2
unnamed: D73.1, Q26.3
unnamed: D75.2, D76.2, D77.2, Q29.1, R33.2
unnamed: D78.2, D79.2, Q30.1, R34.2
unnamed: D80.1, Q29.3
unnamed: D80.2, D81.2, Q31.1, R35.2
unnamed: D82.2, D83.2, D84.2, Q32.1, R36.2
unnamed: D83.1, Q30.3
unnamed: D85.2, D86.2, D87.2, D88.2, D89.2, D90.2, D91.2, D92.2, Q33.1, R37.2
unnamed: D97.1, Q33.3
unnamed: D103.1, D104.1, D105.1, D106.1, Q35.1, R43.1
VCC: C1.1, C2.1, J3.1, R1.1, R2.1, R3.1, R4.1, R5.1, R6.1, R7.1, R8.1, R9.1, R10.1, R11.1, R12.1, R13.1, R14.1, R15.1, R16.1, R17.1, R18.1, R19.1, R20.1, R21.1, R22.1, R23.1, R24.1, R25.1, R26.1, R27.1, R28.1, R29.1, R30.1, R31.1, R32.1, R33.1, R34.1, R35.1, R36.1, R37.1, R38.1, R39.1, R40.1, R41.1, R42.1
