imihajlow/discrete-clock/sch/decoder/decoder.kicad_pcb

## KiCad design sch/decoder/decoder.kicad_pcb (2018-12-07)

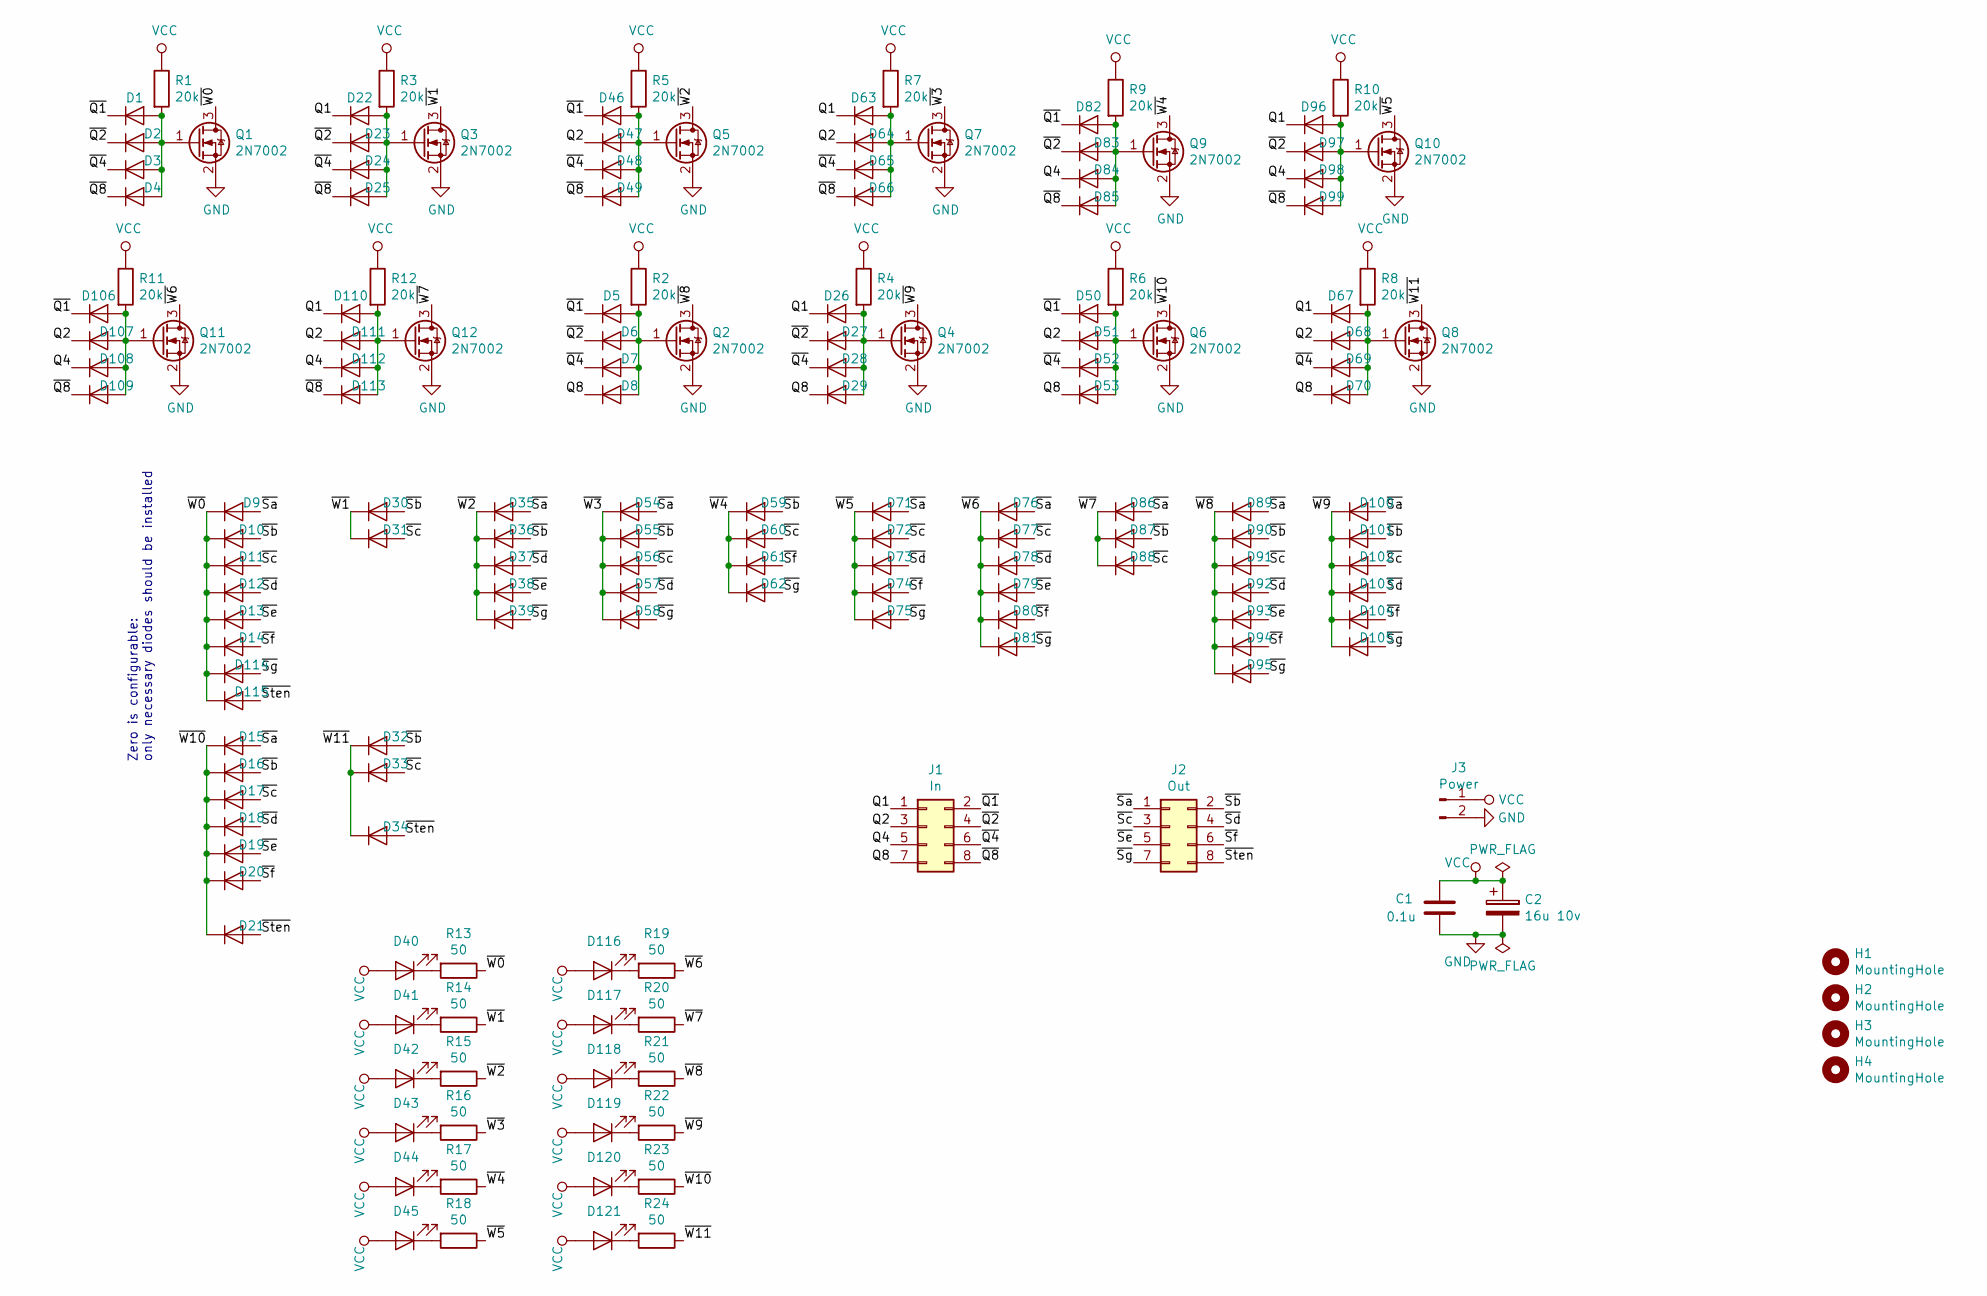
[picture p11: schematic decoder.sch]

Parts:
C1: 0.1u; C_0805_2012Metric
C2: 16u 10v; CP_EIA-3528-21_Kemet-B
D1, D2, D3, D4, D5, D6, D7, D8, D9, D10, D11, D12, D13, D14, D15, D16, D17, D18, D19, D20, D21, D22, D23, D24, D25, D26, D27, D28, D29, D30, D31, D32, D33, D34, D35, D36, D37, D38, D39, D46, D47, D48, D49, D50, D51, D52, D53, D54, D55, D56, D57, D58, D59, D60, D61, D62, D63, D64, D65, D66, D67, D68, D69, D70, D71, D72, D73, D74, D75, D76, D77, D78, D79, D80, D81, D82, D83, D84, D85, D86, D87, D88, D89, D90, D91, D92, D93, D94, D95, D96, D97, D98, D99, D100, D101, D102, D103, D104, D105, D106, D107, D108, D109, D110, D111, D112, D113, D114, D115: D; D_MiniMELF
D40, D41, D42, D43, D44, D45, D116, D117, D118, D119, D120, D121: LED; LED_0805_2012Metric
H1, H2, H3, H4: MountingHole; MountingHole_3.2mm_M3_DIN965_Pad
J1: In; IDC-Header_2x04_P2.54mm_Vertical
J2: Out; IDC-Header_2x04_P2.54mm_Vertical
J3: Power; PinHeader_1x02_P2.54mm_Vertical
Q1, Q2, Q3, Q4, Q5, Q6, Q7, Q8, Q9, Q10, Q11, Q12: 2N7002; SOT-23
R1, R2, R3, R4, R5, R6, R7, R8, R9, R10, R11, R12: 20k; R_0805_2012Metric
R13, R14, R15, R16, R17, R18, R19, R20, R21, R22, R23, R24: 50; R_0805_2012Metric

Connections:
/Q1: D22.1 (K), D26.1 (K), D63.1 (K), D67.1 (K), D96.1 (K), D110.1 (K), J1.1
/Q2: D47.1 (K), D51.1 (K), D64.1 (K), D68.1 (K), D107.1 (K), D111.1 (K), J1.3
/Q4: D84.1 (K), D98.1 (K), D108.1 (K), D112.1 (K), J1.5
/Q8: D8.1 (K), D29.1 (K), D53.1 (K), D70.1 (K), J1.7
/~Q1: D1.1 (K), D5.1 (K), D46.1 (K), D50.1 (K), D82.1 (K), D106.1 (K), J1.2
/~Q2: D2.1 (K), D6.1 (K), D23.1 (K), D27.1 (K), D83.1 (K), D97.1 (K), J1.4
/~Q4: D3.1 (K), D7.1 (K), D24.1 (K), D28.1 (K), D48.1 (K), D52.1 (K), D65.1 (K), D69.1 (K), J1.6
/~Q8: D4.1 (K), D25.1 (K), D49.1 (K), D66.1 (K), D85.1 (K), D99.1 (K), D109.1 (K), D113.1 (K), J1.8
/~Sa: D9.2 (A), D15.2 (A), D35.2 (A), D54.2 (A), D71.2 (A), D76.2 (A), D86.2 (A), D89.2 (A), D100.2 (A), J2.1
/~Sb: D10.2 (A), D16.2 (A), D30.2 (A), D32.2 (A), D36.2 (A), D55.2 (A), D59.2 (A), D87.2 (A), D90.2 (A), D101.2 (A), J2.2
/~Sc: D11.2 (A), D17.2 (A), D31.2 (A), D33.2 (A), D56.2 (A), D60.2 (A), D72.2 (A), D77.2 (A), D88.2 (A), D91.2 (A), D102.2 (A), J2.3
/~Sd: D12.2 (A), D18.2 (A), D37.2 (A), D57.2 (A), D73.2 (A), D78.2 (A), D92.2 (A), D103.2 (A), J2.4
/~Se: D13.2 (A), D19.2 (A), D38.2 (A), D79.2 (A), D93.2 (A), J2.5
/~Sf: D14.2 (A), D20.2 (A), D61.2 (A), D74.2 (A), D80.2 (A), D94.2 (A), D104.2 (A), J2.6
/~Sg: D39.2 (A), D58.2 (A), D62.2 (A), D75.2 (A), D81.2 (A), D95.2 (A), D105.2 (A), D114.2 (A), J2.7
/~Sten: D21.2 (A), D34.2 (A), D115.2 (A), J2.8
/~W0: D9.1 (K), D10.1 (K), D11.1 (K), D12.1 (K), D13.1 (K), D14.1 (K), D114.1 (K), D115.1 (K), Q1.3 (D), R13.1
/~W1: D30.1 (K), D31.1 (K), Q3.3 (D), R14.1
/~W2: D35.1 (K), D36.1 (K), D37.1 (K), D38.1 (K), D39.1 (K), Q5.3 (D), R15.1
/~W3: D54.1 (K), D55.1 (K), D56.1 (K), D57.1 (K), D58.1 (K), Q7.3 (D), R16.1
/~W4: D59.1 (K), D60.1 (K), D61.1 (K), D62.1 (K), Q9.3 (D), R17.1
/~W5: D71.1 (K), D72.1 (K), D73.1 (K), D74.1 (K), D75.1 (K), Q10.3 (D), R18.1
/~W6: D76.1 (K), D77.1 (K), D78.1 (K), D79.1 (K), D80.1 (K), D81.1 (K), Q11.3 (D), R19.1
/~W7: D86.1 (K), D87.1 (K), D88.1 (K), Q12.3 (D), R20.1
/~W8: D89.1 (K), D90.1 (K), D91.1 (K), D92.1 (K), D93.1 (K), D94.1 (K), D95.1 (K), Q2.3 (D), R21.1
/~W9: D100.1 (K), D101.1 (K), D102.1 (K), D103.1 (K), D104.1 (K), D105.1 (K), Q4.3 (D), R22.1
/~W10: D15.1 (K), D16.1 (K), D17.1 (K), D18.1 (K), D19.1 (K), D20.1 (K), D21.1 (K), Q6.3 (D), R23.1
/~W11: D32.1 (K), D33.1 (K), D34.1 (K), Q8.3 (D), R24.1
GND: C1.2, C2.2, J3.2, Q1.2 (S), Q2.2 (S), Q3.2 (S), Q4.2 (S), Q5.2 (S), Q6.2 (S), Q7.2 (S), Q8.2 (S), Q9.2 (S), Q10.2 (S), Q11.2 (S), Q12.2 (S)
unnamed: D1.2 (A), D2.2 (A), D3.2 (A), D4.2 (A), Q1.1 (G), R1.2
unnamed: D5.2 (A), D6.2 (A), D7.2 (A), D8.2 (A), Q2.1 (G), R2.2
unnamed: D22.2 (A), D23.2 (A), D24.2 (A), D25.2 (A), Q3.1 (G), R3.2
unnamed: D26.2 (A), D27.2 (A), D28.2 (A), D29.2 (A), Q4.1 (G), R4.2
unnamed: D40.1 (K), R13.2
unnamed: D41.1 (K), R14.2
unnamed: D42.1 (K), R15.2
unnamed: D43.1 (K), R16.2
unnamed: D44.1 (K), R17.2
unnamed: D45.1 (K), R18.2
unnamed: D46.2 (A), D47.2 (A), D48.2 (A), D49.2 (A), Q5.1 (G), R5.2
unnamed: D50.2 (A), D51.2 (A), D52.2 (A), D53.2 (A), Q6.1 (G), R6.2
unnamed: D63.2 (A), D64.2 (A), D65.2 (A), D66.2 (A), Q7.1 (G), R7.2
unnamed: D67.2 (A), D68.2 (A), D69.2 (A), D70.2 (A), Q8.1 (G), R8.2
unnamed: D82.2 (A), D83.2 (A), D84.2 (A), D85.2 (A), Q9.1 (G), R9.2
unnamed: D96.2 (A), D97.2 (A), D98.2 (A), D99.2 (A), Q10.1 (G), R10.2
unnamed: D106.2 (A), D107.2 (A), D108.2 (A), D109.2 (A), Q11.1 (G), R11.2
unnamed: D110.2 (A), D111.2 (A), D112.2 (A), D113.2 (A), Q12.1 (G), R12.2
unnamed: D116.1 (K), R19.2
unnamed: D117.1 (K), R20.2
unnamed: D118.1 (K), R21.2
unnamed: D119.1 (K), R22.2
unnamed: D120.1 (K), R23.2
unnamed: D121.1 (K), R24.2
VCC: C1.1, C2.1, D40.2 (A), D41.2 (A), D42.2 (A), D43.2 (A), D44.2 (A), D45.2 (A), D116.2 (A), D117.2 (A), D118.2 (A), D119.2 (A), D120.2 (A), D121.2 (A), J3.1, R1.1, R2.1, R3.1, R4.1, R5.1, R6.1, R7.1, R8.1, R9.1, R10.1, R11.1, R12.1

Notes on the sheet:
Zero is configurable: only necessary diodes should be installed

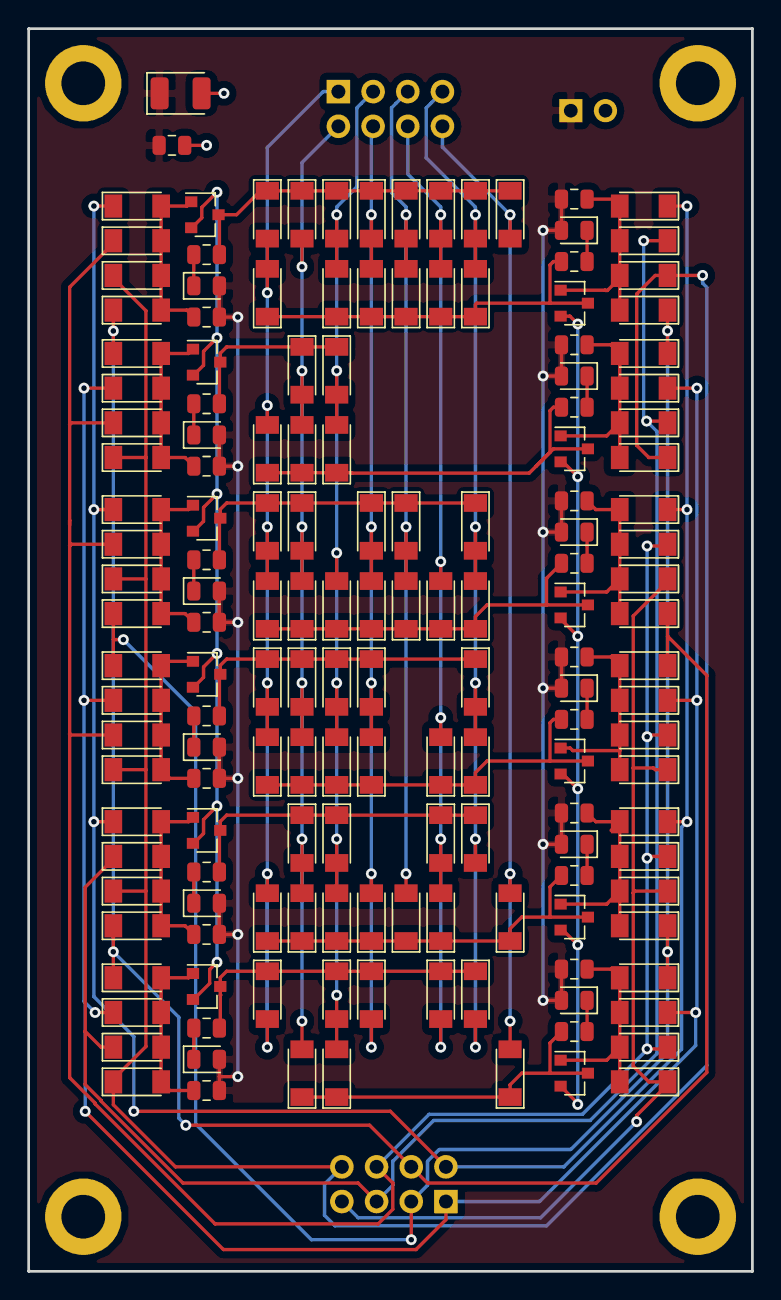
[picture p12: board decoder.kicad_pcb from above]

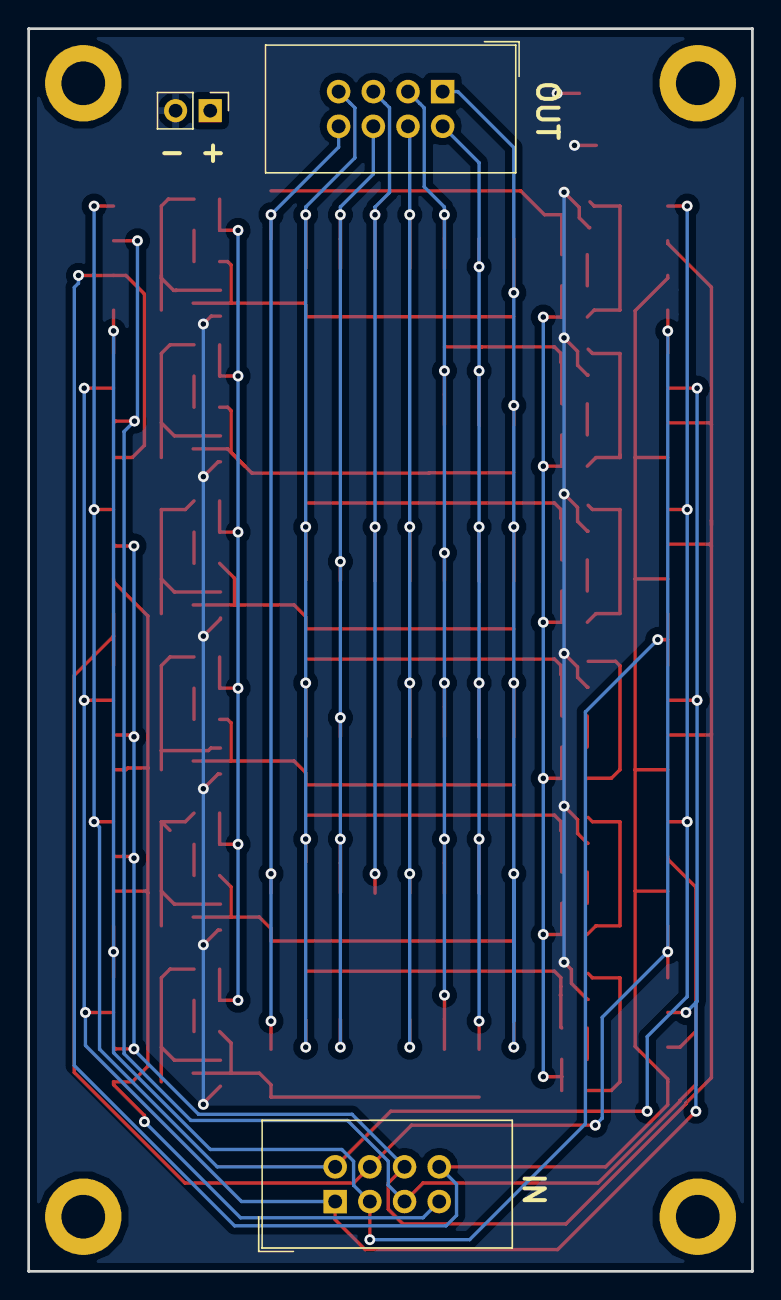
[picture p13: board decoder.kicad_pcb from below]

Board: 2 copper layers, 53.0 x 91.0 mm, 166 parts (3 on the bottom side), 54 nets.
