imihajlow/discrete-clock/(commit log)

2018-11-20 Working diode-nmos flip-flop simulation
2018-11-20 Resistance parameter
    The higher the resistance the higher the stability
2018-11-24 Counter schematic added
    [carry.sch, counter.kicad_pcb, counter.sch, flip-flop.sch, reset.sch]
2018-11-24 Counter schematic improvements
    [_saved_counter.sch, carry.sch, reset.sch]
2018-11-24 Counter model
    [clock.circ]
2018-11-24 Removed unneed file
    [_saved_counter.sch]
2018-11-27 One flip-flop is placed on PCB
    [carry.sch, counter.kicad_pcb, counter.sch, flip-flop.sch, reset.sch]
2018-11-30 The counter board is complete
    [counter.kicad_pcb, flip-flop.sch, reset.sch]
2018-12-01 Removed unused jumpers
    [flip-flop.sch]
2018-12-03 Board modified: connectors used
    [counter.kicad_pcb, counter.sch]
2018-12-04 Decoder scematic added
    [decoder.kicad_pcb, decoder.sch]
2018-12-06 Decoder board added
    Also schematics modified: added LEDs, configurable zero
    [decoder.kicad_pcb, decoder.sch]
2018-12-07 Decoder board finished
    [decoder.kicad_pcb]
2018-12-07 Modified the counter board
    Added mounting holes to the schematics
    Changed reset connector to have 2 pins
    Added labels for connectors and configuration diodes
    [counter.kicad_pcb, counter.sch]
2018-12-15 Added display board schematics and reset model
    [display.kicad_pcb, display.sch, nxor.sch, pwm.sch]
2018-12-17 7-segment indicator footprint is added
    [display.sch, nxor.sch]
2018-12-18 Button footprint added
    [display.sch]
2019-01-04 Power supply schematic and clock generation model
    [power.kicad_pcb, power.sch]
2019-01-06 Added datasheets, set component values, calculated LED resistors
    [carry.sch, counter.sch, decoder.sch, display.sch, flip-flop.sch, nxor.sch, reset.sch]
2019-01-09 Added bill of materials, modified counter PCB
    Adjusted component positions for better GND filling
    [counter.kicad_pcb, flip-flop.sch]
2019-01-12 Display board, BOM updated
    [display.kicad_pcb, display.sch, nxor.sch]
2019-01-13 Power supply board
    [power.kicad_pcb, power.sch]
2019-01-13 Display module board
    [display-module.kicad_pcb, display-module.sch, nxor.sch]
2019-01-13 Deleted some models
    [clock.circ]
